Kivin2/Robotica_2_Soto_Bot/Board.PNG

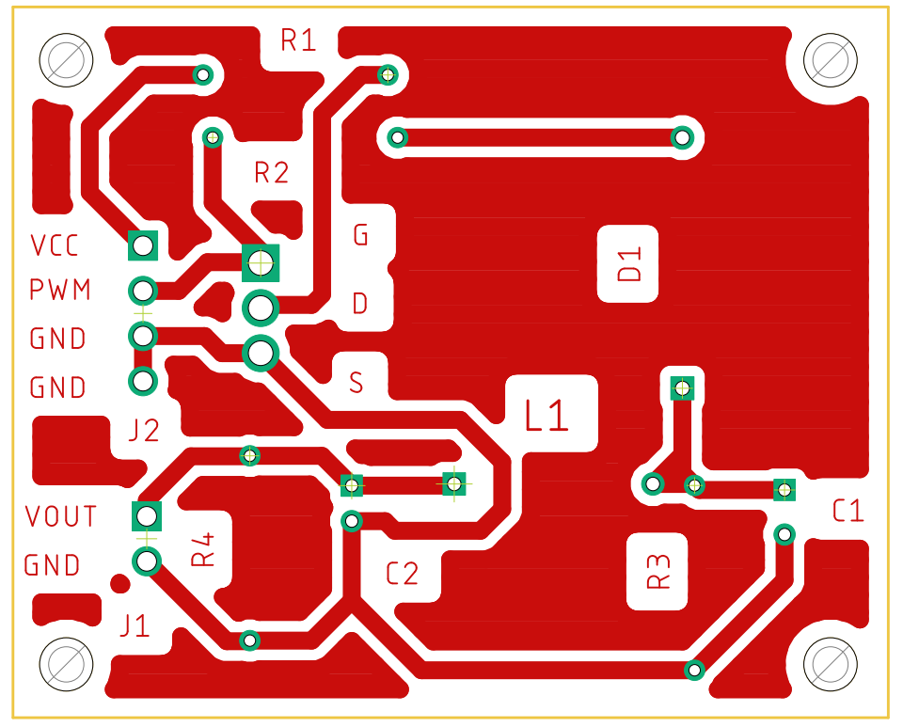
Board.PNG
