Kivin2/Robotica_2_Soto_Bot/Hardware/ListaDeComponentes.xlsx

NOMBRE | VALOR | FOOTPRINT | FABRICANTE | P/N | F/B | DISTRIBUIDOR | DESCRIPCION | CANTIDAD | PRICE (USD) | URL
C1 | 0.1uF | THROUGH HOLE | Vishay | 594-K104K10X7RF5TL2 | K104K10X7RF5TL2 | MOUSER | Capacitor 0.1uF 50Vdc | 1 | $0.23 | https://www.mouser.cl/ProductDetail/Vishay-BC-Components/K104K10X7RF5TL2?qs=B4Lc6Tv24tbCh1UvC16VNg%3D%3D
C2 | 10uF | THROUGH HOLE | Cornell Dubilier - CDE | 539-SEK50V10 | SEK100M050ST | MOUSER | Capacitor 10uF 50Vdc | 1 | $0.74 | https://www.mouser.cl/ProductDetail/Cornell-Dubilier-CDE/SEK100M050ST?qs=SToNfkNuIf70OBUI1whdlA%3D%3D
D1 | 1N4007 | THROUGH HOLE | Diotec Semiconductor | 637-1N4007 | 1N4007 | MOUSER | Diodo 1N4007 | 1 | $0.40 | https://www.mouser.cl/ProductDetail/Diotec-Semiconductor/1N4007?qs=OlC7AqGiEDmK9mU1uTiCkg%3D%3D
R1,R2 | 1k | THROUGH HOLE | KOA Speer | 660-MF1/4DCT52A1002F | MF1/4DCT52A1002F | MOUSER | Resistors 1k 1/4W | 2 | $0.14 | https://www.mouser.cl/ProductDetail/KOA-Speer/MF1-4DCT52A1002F?qs=GXuM9q1TrDkY%252BmckAOvGTw%3D%3D
R3 | 33k | THROUGH HOLE | YAGEO | 603-CFR-25JR-52-33K | CFR-25JR-52-33K | MOUSER | Resistor 33k 1/4W | 1 | $0.10 | https://www.mouser.cl/ProductDetail/YAGEO/CFR-25JR-52-33K?qs=KUIzHt%2Fe91l3cEdxPlbEkg%3D%3D
R4 | 10k | THROUGH HOLE | YAGEO | 603-CFR-25JB-52-10K | CFR-25JB-52-10K | MOUSER | Resistor 10k 1/4W | 1 | $0.10 | https://www.mouser.cl/ProductDetail/YAGEO/CFR-25JB-52-10K?qs=oypCK0zG32646UD7yHncYg%3D%3D
L1 | 68uH | THROUGH HOLE | Bourns Inc. | 78F680J-RC | M10144-ND | DIGIKEY | Inductor 68uH | 1 | $0.30 | https://www.digikey.com/en/products/detail/bourns-inc/78F680J-RC/1306002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
Q1 | IRF520 | THROUGH HOLE | Vishay | 844-IRF520PBF | IRF520PBF | MOUSER | MOSFET N-MOS IRF520PBF TO-220 | 1 | $1.17 | https://www.mouser.cl/ProductDetail/Vishay-Semiconductors/IRF520PBF?qs=%2FRKvNCQzLu0LFYQuStTxKg%3D%3D
