Kivin2/Robotica_2_Soto_Bot/Hardware/LibrariesEagle/Capacitor01u/K104K10X7RF5TL2/3D/K104K10X7RF5TL2.stp

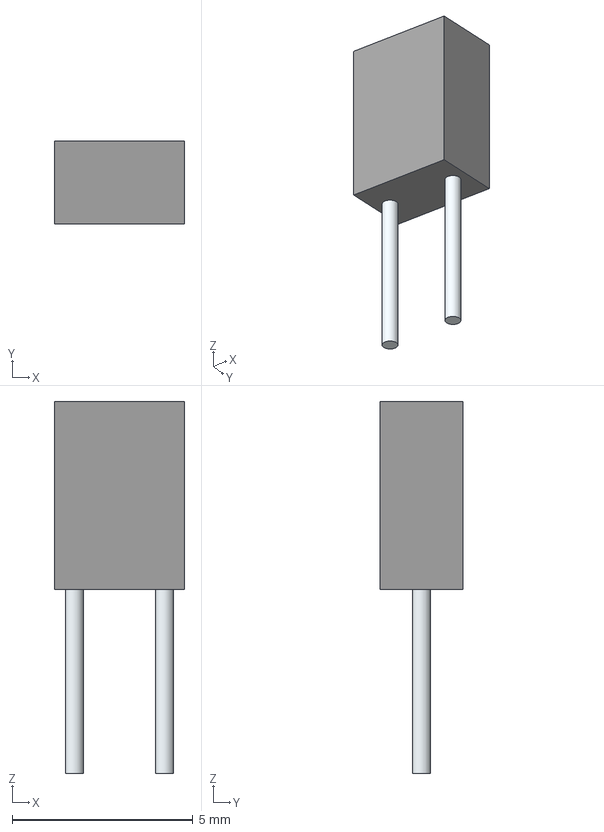
[picture p10: CAD file, 2023-05-31]
Hardware/LibrariesEagle/Capacitor01u/K104K10X7RF5TL2/3D/K104K10X7RF5TL2.stp
3.60 x 2.30 x 10.3 mm
Leads
