Kivin2/Robotica_2_Soto_Bot/Hardware/LibrariesEagle/Capacitor10u/SEK100M050ST/3D/SEK100M050ST.stp

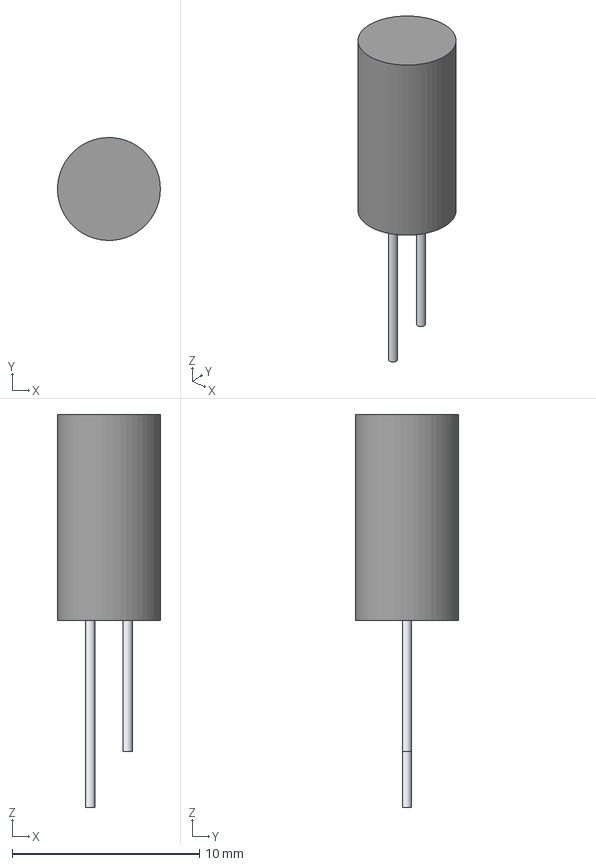
[picture p11: CAD file, 2023-05-31]
Hardware/LibrariesEagle/Capacitor10u/SEK100M050ST/3D/SEK100M050ST.stp
5.49 x 5.50 x 21.0 mm
SimpleBody
Pin1
Pin2
