Kivin2/Robotica_2_Soto_Bot/Hardware/LibrariesEagle/Diodo1N4007/1N4007/3D/1N4007.stp

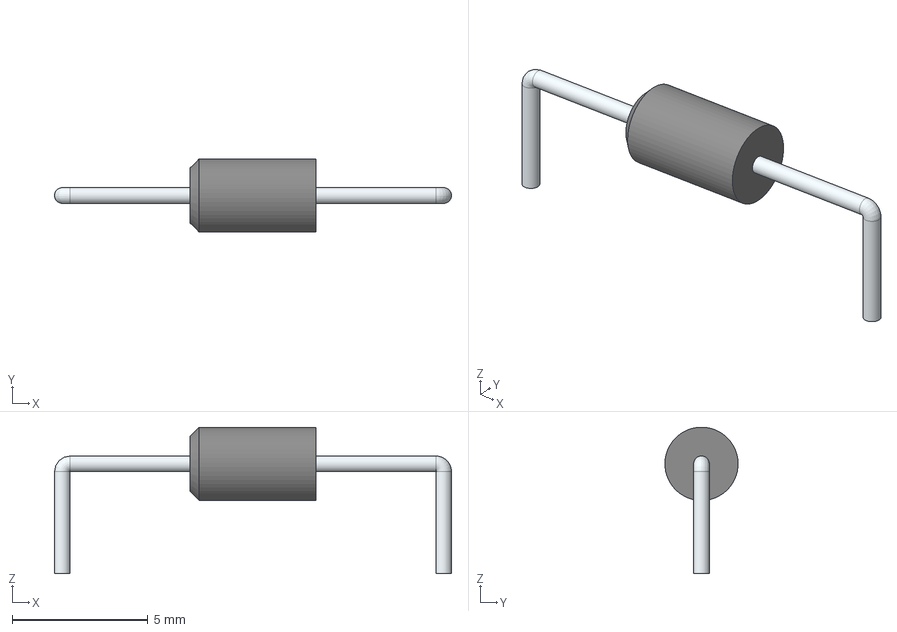
[picture p12: CAD file, 2023-05-31]
Hardware/LibrariesEagle/Diodo1N4007/1N4007/3D/1N4007.stp
14.6 x 2.70 x 5.40 mm
