Kivin2/Robotica_2_Soto_Bot/Hardware/LibrariesEagle/Inductancia68u/IND_BOURNS_78F.step

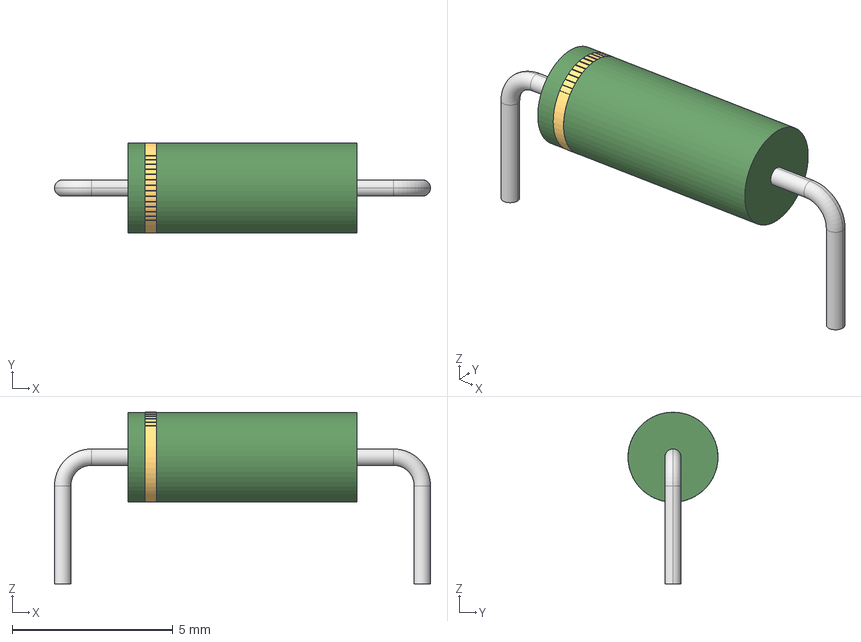
[picture p13: CAD file, 2023-05-31]
Hardware/LibrariesEagle/Inductancia68u/IND_BOURNS_78F.step
11.7 x 2.80 x 5.33 mm
