Kivin2/Robotica_2_Soto_Bot/Hardware/LibrariesEagle/MosfetIRF520/IRF520PBF/3D/IRF520PBF.stp

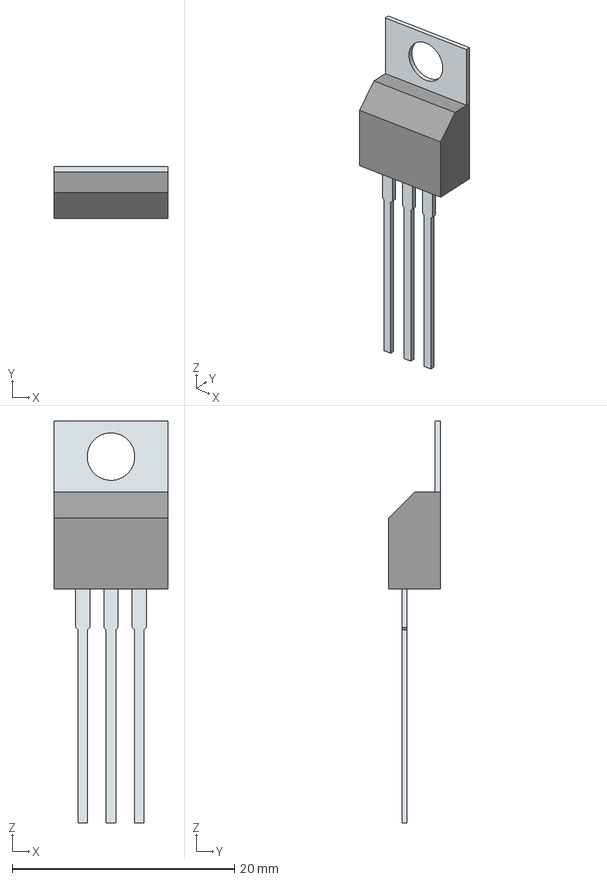
[picture p14: CAD file, 2023-05-31]
Hardware/LibrariesEagle/MosfetIRF520/IRF520PBF/3D/IRF520PBF.stp
10.2 x 4.65 x 36.1 mm
Tab
PinsArray
