Kivin2/Robotica_2_Soto_Bot/Hardware/LibrariesEagle/Raspberry/SC0915--3DModel-STEP-56544.STEP

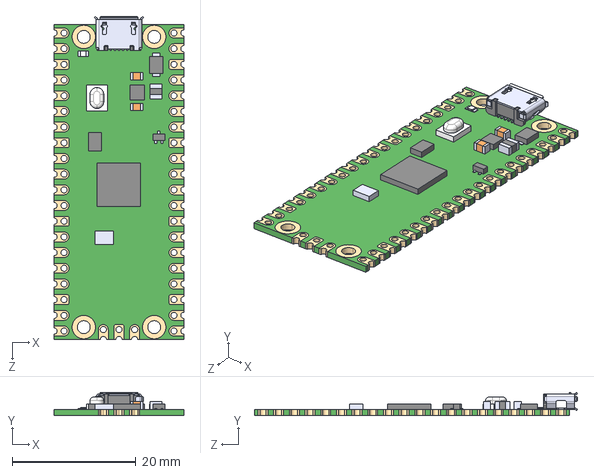
[picture p15: CAD file, 2023-06-01]
Hardware/LibrariesEagle/Raspberry/SC0915--3DModel-STEP-56544.STEP
21.0 x 3.73 x 52.3 mm
