Kivin2/Robotica_2_Soto_Bot/Hardware/LibrariesEagle/Resistencias/CMF501K0000FHEB/3D/CMF501K0000FHEB.stp

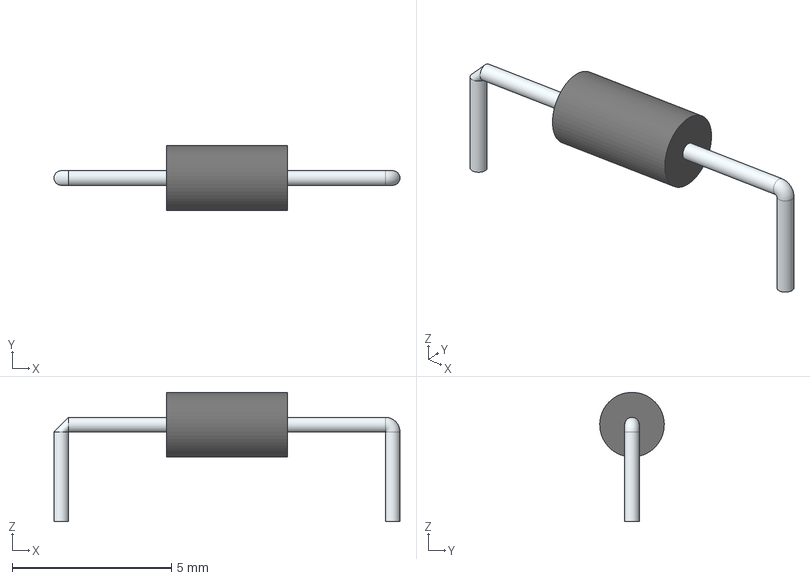
[picture p16: CAD file, 2023-05-31]
Hardware/LibrariesEagle/Resistencias/CMF501K0000FHEB/3D/CMF501K0000FHEB.stp
10.9 x 2.03 x 4.06 mm
SimpleBody
