Kivin2/Robotica_2_Soto_Bot/(list of files, cad)

Other CAD files:
Hardware/LibrariesEagle/Capacitor01u/K104K10X7RF5TL2/Allegro/k104k10x7rf5tl2.psm
Hardware/LibrariesEagle/Capacitor01u/K104K10X7RF5TL2/DEHDL/k104k10x7rf5tl2/chips/chips.prt
Hardware/LibrariesEagle/Capacitor10u/SEK100M050ST/Allegro/capprd200w50d525h1100.psm
Hardware/LibrariesEagle/Capacitor10u/SEK100M050ST/DEHDL/sek100m050st/chips/chips.prt
Hardware/LibrariesEagle/Diodo1N4007/1N4007/Allegro/dioad1405w58l465d235.psm
Hardware/LibrariesEagle/Diodo1N4007/1N4007/DEHDL/1n4007/chips/chips.prt
Hardware/LibrariesEagle/MosfetIRF520/IRF520PBF/Allegro/to254p465x1024x2050-3p.psm
Hardware/LibrariesEagle/MosfetIRF520/IRF520PBF/DEHDL/irf520pbf/chips/chips.prt
Hardware/LibrariesEagle/Resistencias/CMF501K0000FHEB/Allegro/resad1041w46l381d165.psm
Hardware/LibrariesEagle/Resistencias/CMF501K0000FHEB/DEHDL/cmf501k0000fheb/chips/chips.prt
