Kivin2/Robotica_2_Soto_Bot/Hardware/Esquema Placa de Control de Motores.pdf

# 1k GND

A

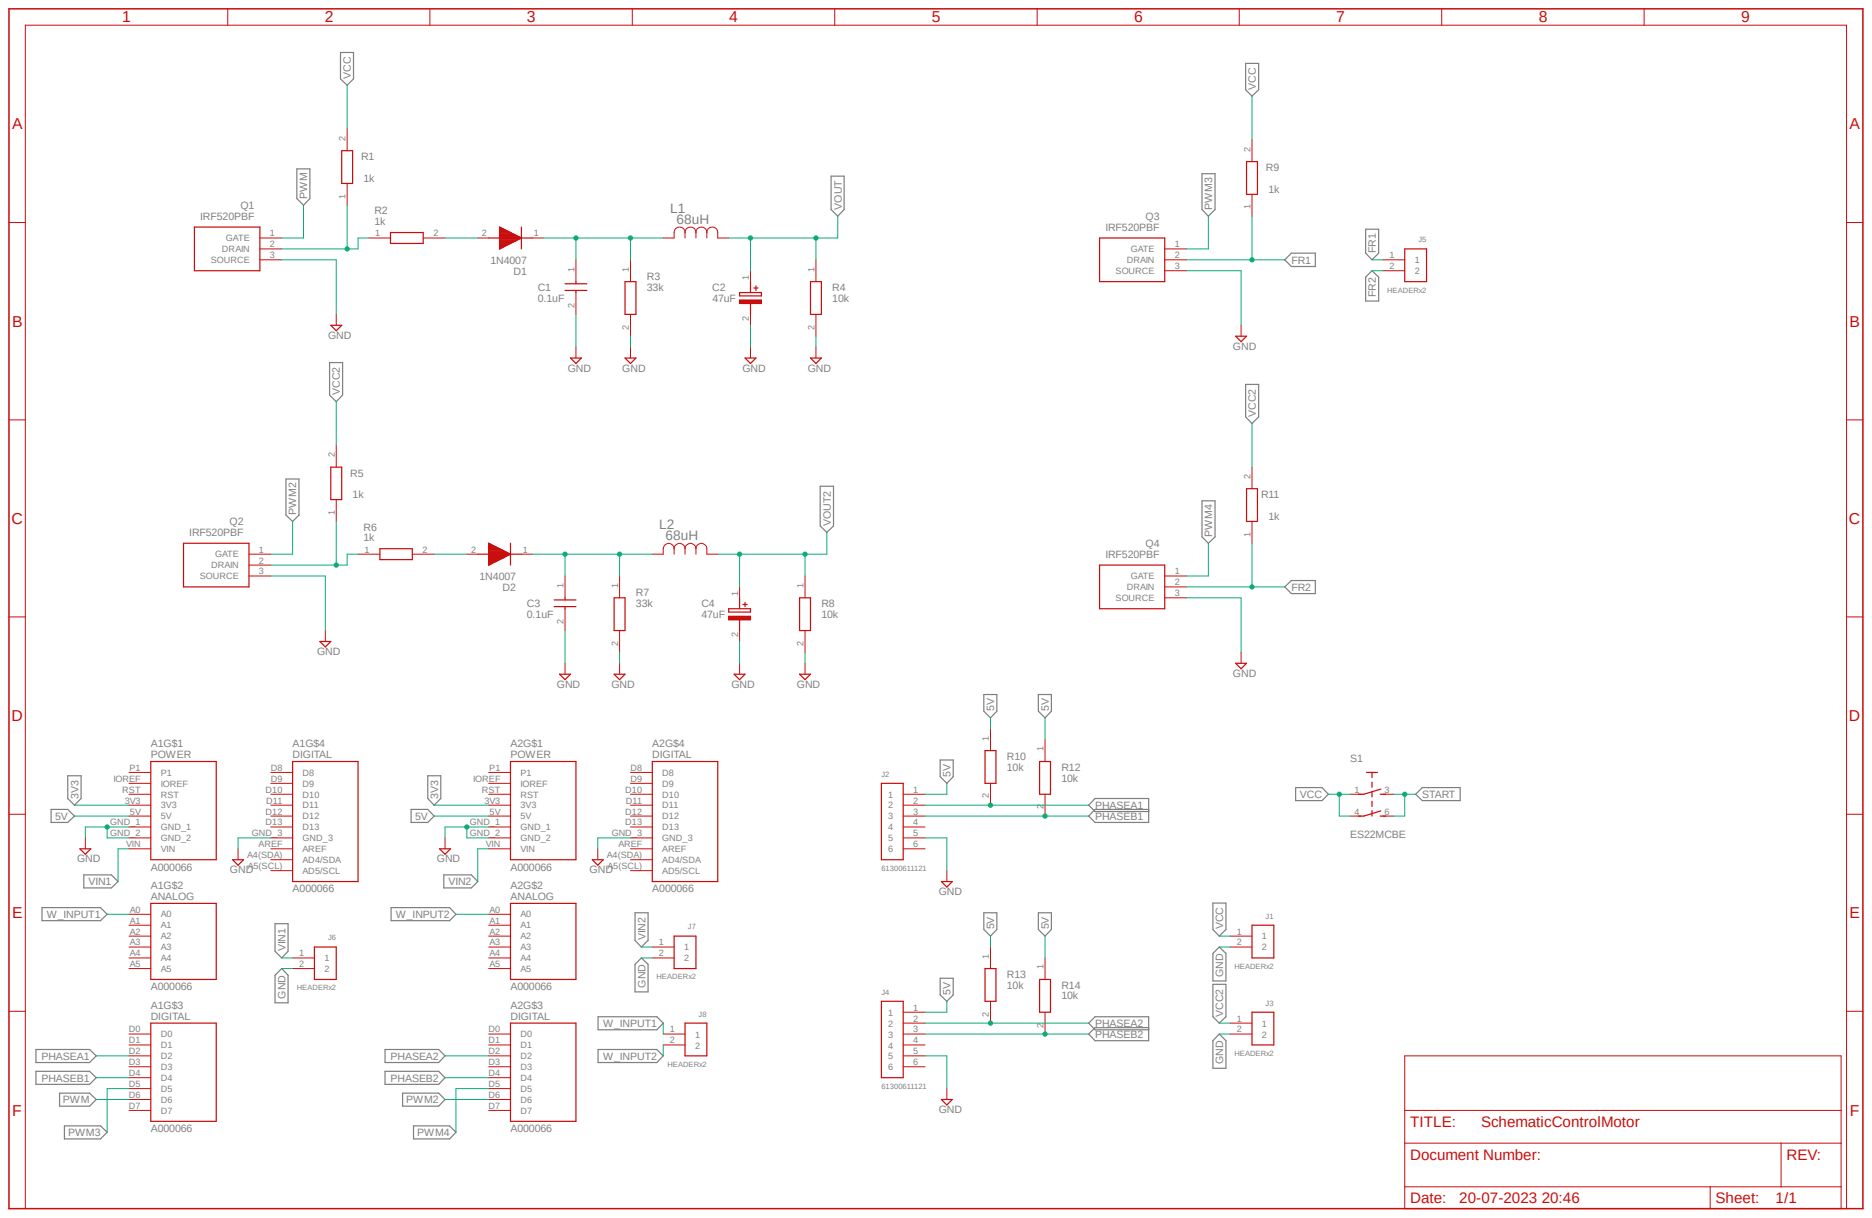
[picture p17: page 1]
