Kivin2/Robotica_2_Soto_Bot/Hardware/SPICE/ArduinoToDriver.asc

C1: cap; 0.1µ
C2: cap; 47µ
D1: diode; 1N4148
L1: ind; 68µ
M1: nmos; IRF530
R1: res; 10k
R2: res; 1k
R3: res; 1k
R4: res; 33k
V1: voltage; 10
V2: signal; PULSE(0 5 0 1u 1u {X} 1m)
Named nets: 0, Vo
.tran 0 1 0 25u
.step param X list 0.1m 0.2m 0.3m
