Kivin2/Robotica_2_Soto_Bot/Hardware/SchematicControlMotor.brd

## EAGLE design Hardware/SchematicControlMotor.brd (2023-07-21)

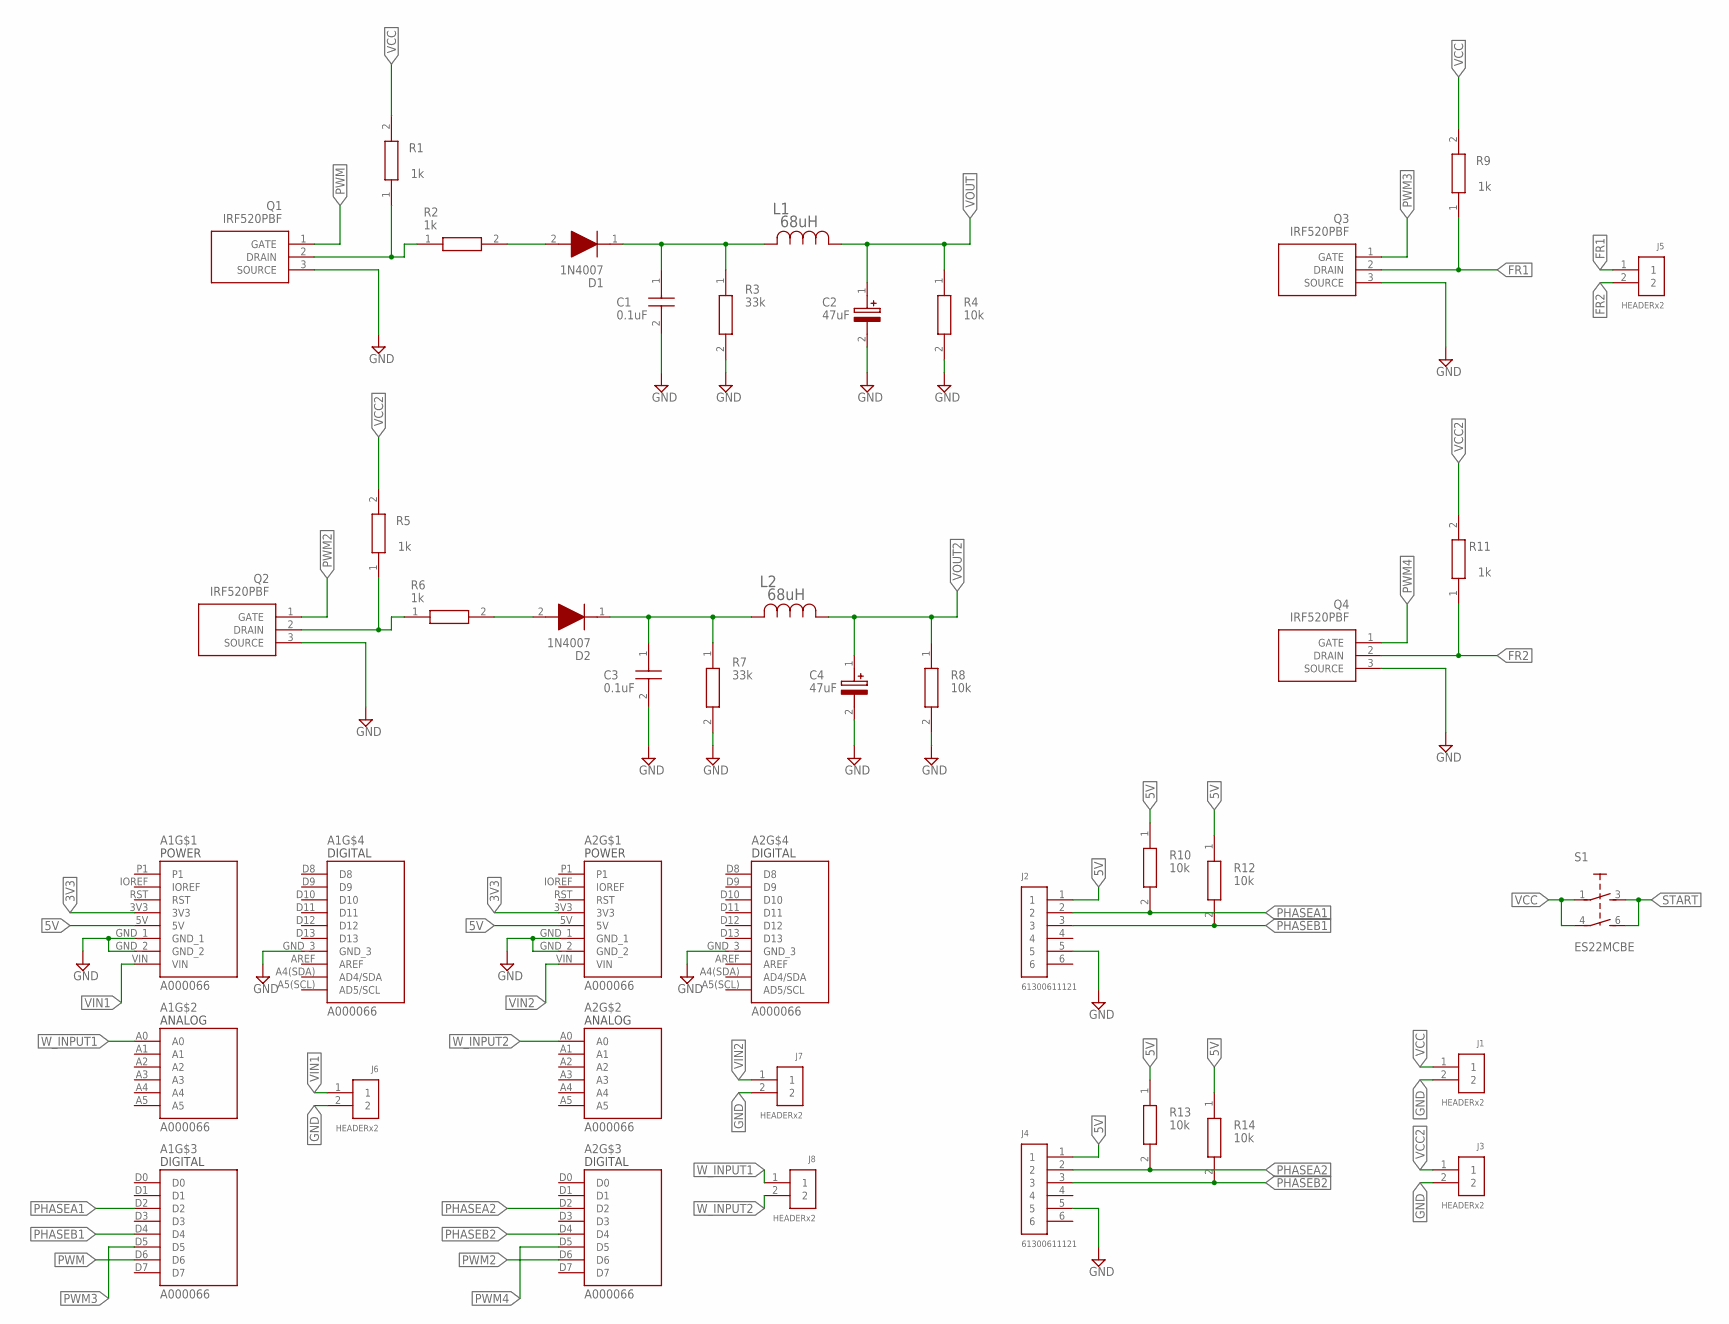
[picture p18: schematic SchematicControlMotor.sch]

Parts:
A1, A2: A000066; ARDUINO_A000066
C1, C3: 0.1uF; K104K10X7RF5TL2
C2, C4: 47uF; CAPPRD200W50D525H1100
D1, D2: 1N4007; DIOAD1405W58L465D235
J1, J3, J5, J6, J7, J8: HEADERx2; 61300211121
J2, J4: 61300611121
L1, L2: 68uH; IND_BOURNS_78F
Q1, Q2, Q3, Q4: IRF520PBF; TO254P465X1024X2050-3P
R1, R2, R5, R6, R9, R11: 1k; RESAD1041W46L381D165
R3, R7: 33k; RESAD1041W46L381D165
R4, R8, R10, R12, R13, R14: 10k; RESAD1041W46L381D165
S1: ES22MCBE

Connections:
3V3: A1.3V3, A2.3V3
5V: A1.5V, A2.5V, J2.1, J4.1, R10.1, R12.1, R13.1, R14.1
FR1: J5.1, Q3.2 (DRAIN), R9.1
FR2: J5.2, Q4.2 (DRAIN), R11.1
GND: A1.GND_1, A1.GND_2, A1.GND_3, A2.GND_1, A2.GND_2, A2.GND_3, C1.2, C2.2 (-), C3.2, C4.2 (-), J1.2, J2.5, J3.2, J4.5, J6.2, J7.2, Q1.3 (SOURCE), Q2.3 (SOURCE), Q3.3 (SOURCE), Q4.3 (SOURCE), R3.2, R4.2, R7.2, R8.2
unnamed: Q1.2 (DRAIN), R1.1, R2.1
unnamed: D1.2 (A), R2.2
unnamed: C1.1, D1.1 (K), L1.2, R3.1
unnamed: D2.2 (A), R6.2
unnamed: C3.1, D2.1 (K), L2.2, R7.1
unnamed: Q2.2 (DRAIN), R5.1, R6.1
PHASEA1: A1.D2, J2.2, R10.2
PHASEA2: A2.D2, J4.2, R13.2
PHASEB1: A1.D4, J2.3, R12.2
PHASEB2: A2.D4, J4.3, R14.2
PWM: A1.D6, Q1.1 (GATE)
PWM2: A2.D6, Q2.1 (GATE)
PWM3: A1.D5, Q3.1 (GATE)
PWM4: A2.D5, Q4.1 (GATE)
START: S1.3, S1.6
VCC: J1.1, R1.2, R9.2, S1.1, S1.4
VCC2: J3.1, R5.2, R11.2
VIN1: A1.VIN, J6.1
VIN2: A2.VIN, J7.1
VOUT: C2.1 (+), L1.1, R4.1
VOUT2: C4.1 (+), L2.1, R8.1
W_INPUT1: A1.A0, J8.1
W_INPUT2: A2.A0, J8.2

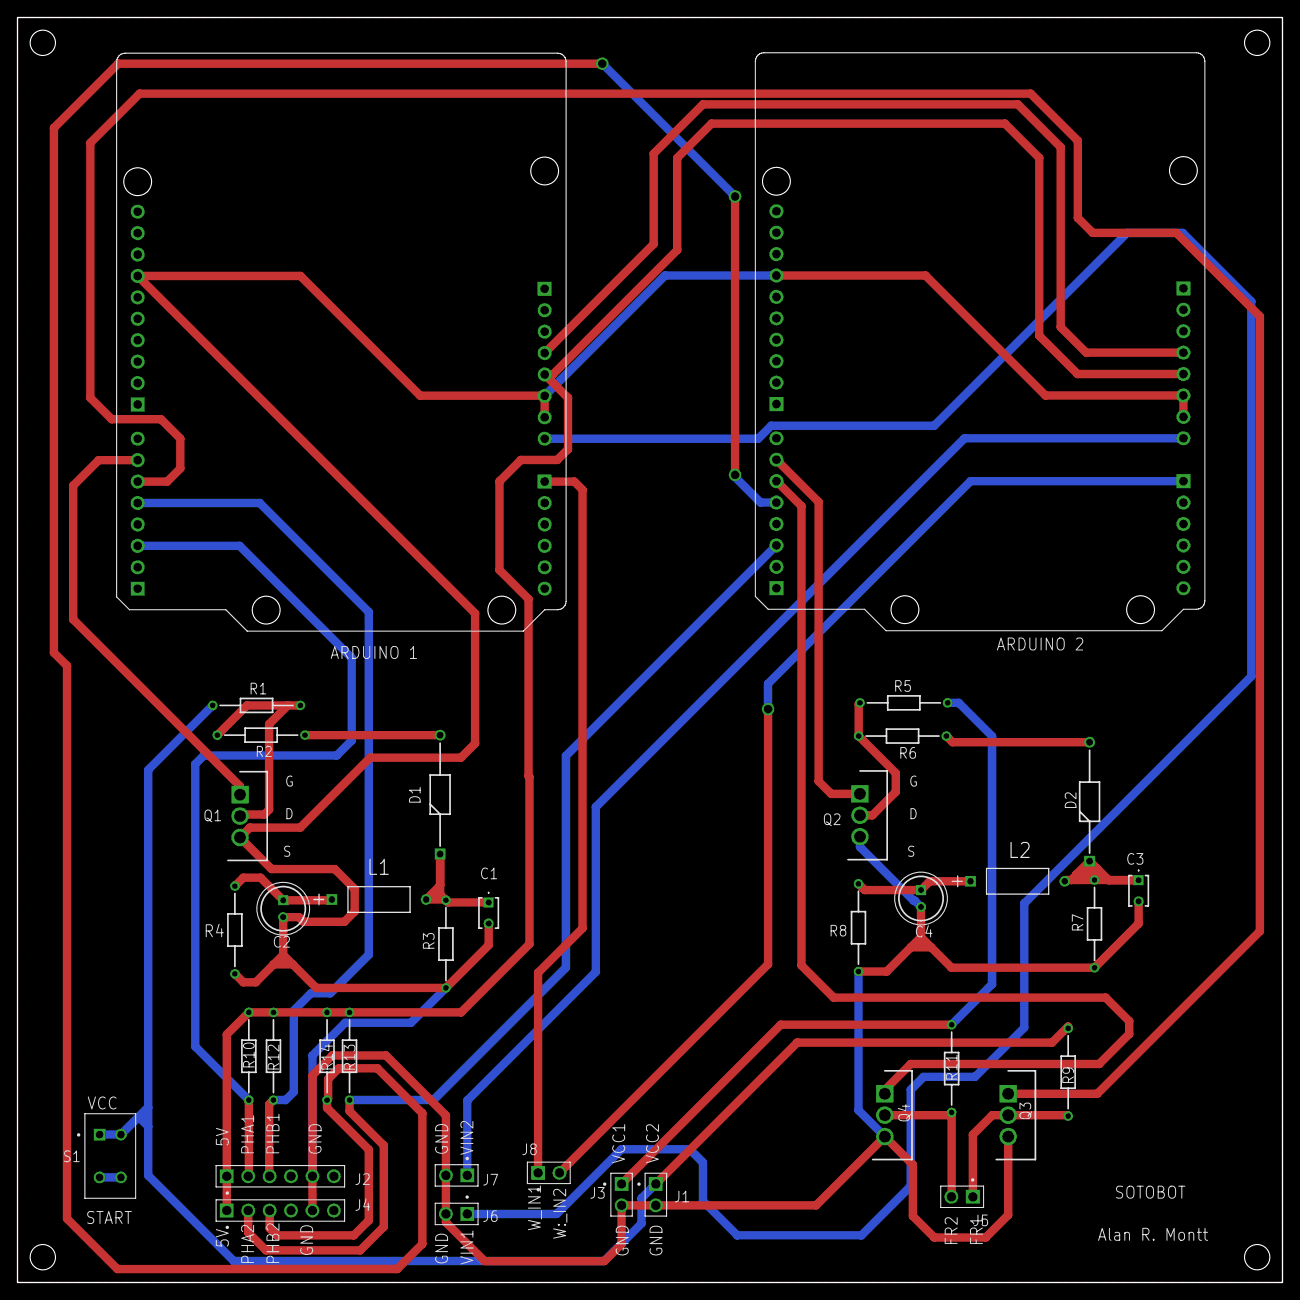
[picture p19: board SchematicControlMotor.brd from above]

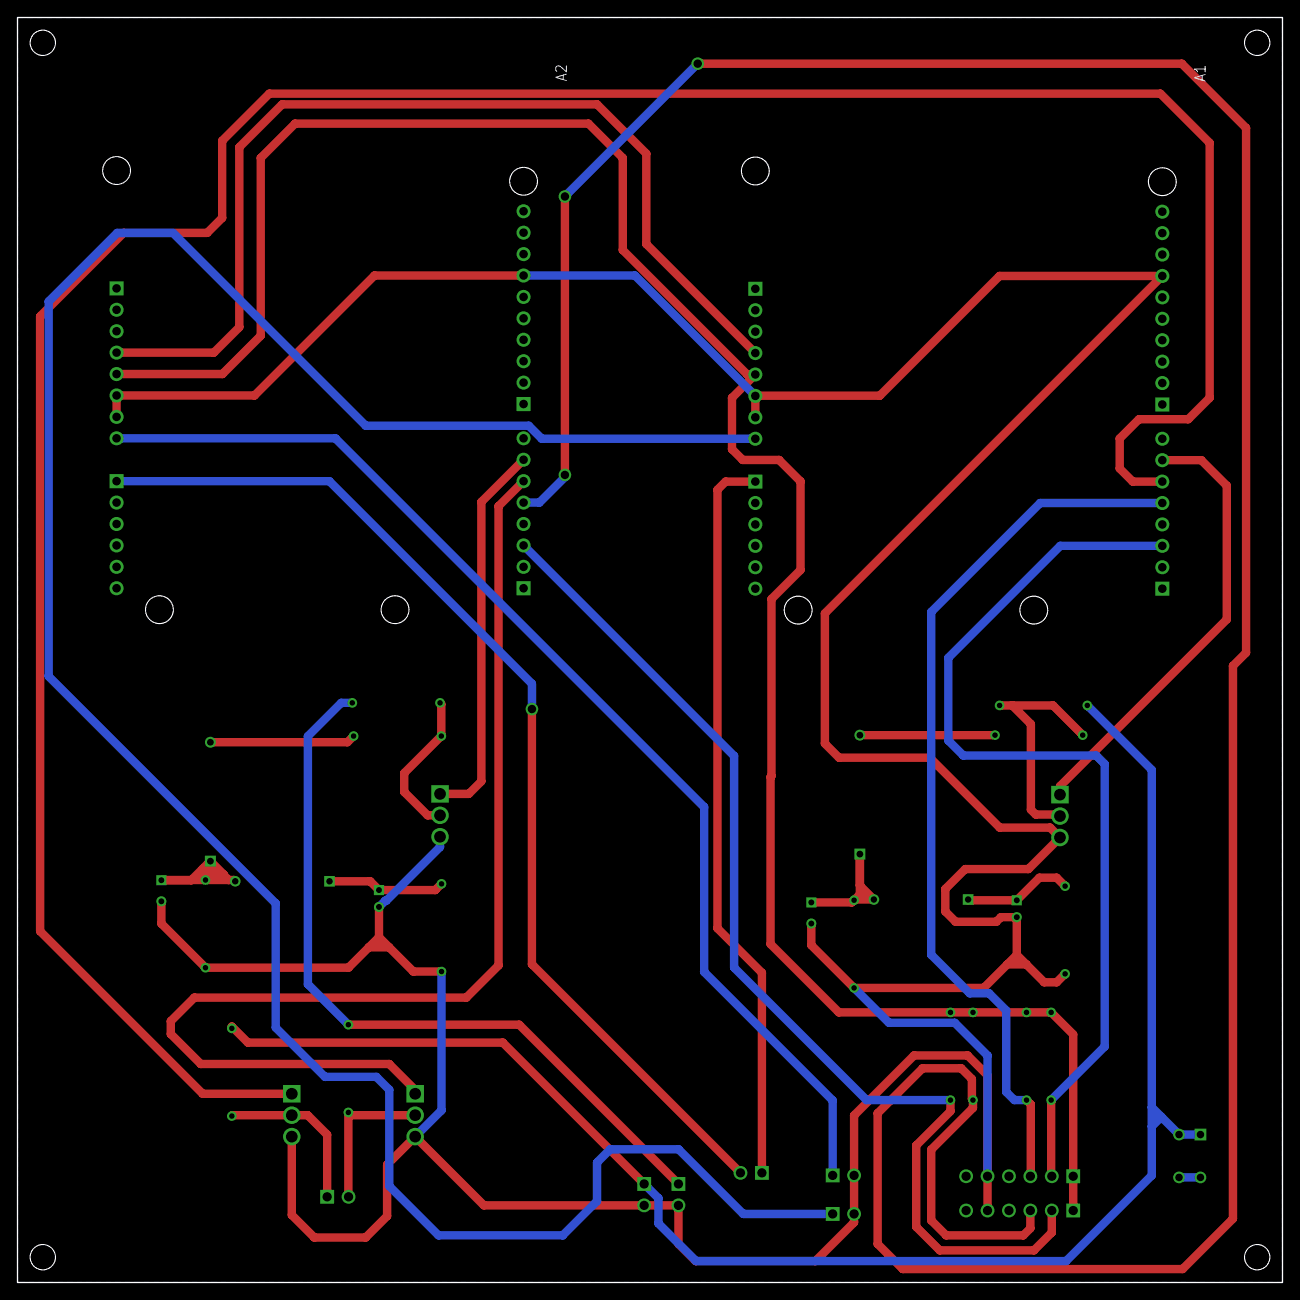
[picture p20: board SchematicControlMotor.brd from below]

Board: 2 copper layers, 150.0 x 150.0 mm, 37 parts (2 on the bottom side), 28 nets.
