Kivin2/Robotica_2_Soto_Bot/(commit log)

2023-05-17 Create Lidar
2023-05-18 Update Lidar
2023-05-25 Update and rename Lidar to Tareas
2023-05-26 Added the .cpp file for Arduino
2023-05-26 Added Footprint Arduino for PCB
2023-05-27 Updated 3D Model for Arduino Footprint
2023-05-31 Circuit Updated
2023-05-31 List of Components Updated
    [1N4007.stp, CMF501K0000FHEB.stp, EDI2CAP.CFG, IND_BOURNS_78F.step, IRF520PBF.stp, K104K10X7RF5TL2.stp, ListaDeComponentes.xlsx, SEK100M050ST.stp]
2023-06-10 PCB Design added
2023-07-21 New PCB and Code
    [SchematicControlMotor.brd, SchematicControlMotor.sch]
