Kivin2/Robotica_2_Soto_Bot/(notices)

Notices in the files:
parts and their libraries:
HardwareRobotica: COPYRIGHT: Copyright (C) 2023 Ultra Librarian. All rights reserved.
